tunayarc/water-level-indicator/report/water-level-indicator-presentation.pdf

Middle East Technical University

Northern Cyprus Campus

# EEE 202 Design Project Presentation

Project 6: Water Level Indicator

Conductive-Probe-Based Discrete Analog Water Level Indicator Circuit

Tunay Arıcı | Mehmet Yama¸c G¨ung¨or | Arda Ardı¸c | Yi˘gitalp Dellal
2688141 | 2585719 | 2689933 | 2585644

## Outline

Motivation, Applications, and Design Requirements

Implemented Circuit Architecture and Operation

Component Selection and Design Calculations

LTspice Verification, Practical Results, and Improvement Directions

## Motivation, Applications, and Design

## Requirements

## Project Statement and Design Requirements

Given design problem

Design a discrete analog water level indicator circuit that detects the water level inside a container and displays the reached level using LED indicators.

Water height → electrical detection → visible LED output

Design parameter | Requirement
Supply voltage | 5 V ≤ VS ≤ 12 V
Detected levels | At least 3 water levels
Output indicator | LEDs
Sensing method | Conductive probes
Circuit type | Discrete analog implementation

Main requirement interpretation

The circuit must convert different water heights into different visible

## Motivation, Applications, and Historical Context

Why level detection matters

| Preventing tank overflow
| Avoiding dry-running of pumps
| Monitoring stored liquid level
| Providing alarm indication

Typical application areas

| Domestic water tanks
| Reservoirs and storage tanks
| Wastewater systems
| Automatic filling systems

Visual inspection → mechanical float → electrical probe → industrial transmitter

Connection to this project

Our design is an educational discrete analog version of electrical probe-based level detection.

## Industrial Applications: Companies and Devices

Company | Example device type | Typical application
Endress+Hauser | Conductive, radar, ultrasonic, hydrostatic sensors | Tanks, silos, wastewater
VEGA | VEGAPULS radar, VEGAFLEX guided radar sensors | Process tanks, storage tanks
Emerson Rosemount | Radar and guided-wave radar transmitters | Industrial level measurement

Industrial meaning

Industrial level measurement systems use different sensing principles depending on the liquid, tank geometry, safety requirements, and operating environment.

Position of our project

Our circuit is not an industrial transmitter. It is a low-cost educational prototype that models the same basic task: detecting liquid level and producing an output.

## Implemented Design Choices

Minimum project requirement

| 5 V to 12 V supply
| Minimum 3 detected levels
| LED-based indication
| Conductive-probe sensing

Our implemented design

| 12 V DC supply
| Six sensing levels
| First five LEDs: steady
indication
| Highest level: blinking alarm
Minimum 3 levels | −→ | 6-level indicator with alarm behavior

Design decision

The highest water level was separated from normal level indication and used as a warning stage instead of only another steady LED.

## Modular Design Flow and Design Evolution

Conductive probe → base drive → BJT switch → LED output

input stabilization → supply protection → astable alarm stage

Version | Main feature | Design role
V1 | Five-level BJT indicator | Basic sensing principle
V2 | Sixth level + blinking alarm | Critical-level warning
V3 | Stabilization + protection | Final implemented design
V4 | MOSFET-based sensing | Lower-current improvement
V5 | AC-based sensing | Corrosion-reduction direction

Presentation focus

The main focus is Version 3: a BJT-based discrete analog circuit with stabilization, protection, and a blinking alarm stage.

## Implemented Circuit Architecture

## and Operation

## Implemented Version 3 Architecture

Main implemented design

Version 3 is the implemented laboratory circuit. It uses conductive probes, BJT switching stages, LED indicators, input stabilization, reverse-polarity protection, and an astable alarm stage.

Water level → probe contact → BJT switching → LED indication

Protection

| 1N5819
| Reverse-polarity
protection

Protected VCC

Repeated sensing

Ordinary probes
Pn
| Water resistance
| BC547B stages

Alarm stage

| Alarm probe PA
| Astable
multivibrator

Blinking LED DA

Circuit structure

The ordinary levels use repeated modules indexed by n, while PA

## Implemented Version 3 Schematic


How to read this schematic

The left side contains the protected supply input, the middle contains the repeated ordinary sensing-and-indication stages, and the right side contains the alarm-level astable stage.

## Physical Implementation of the Circuit

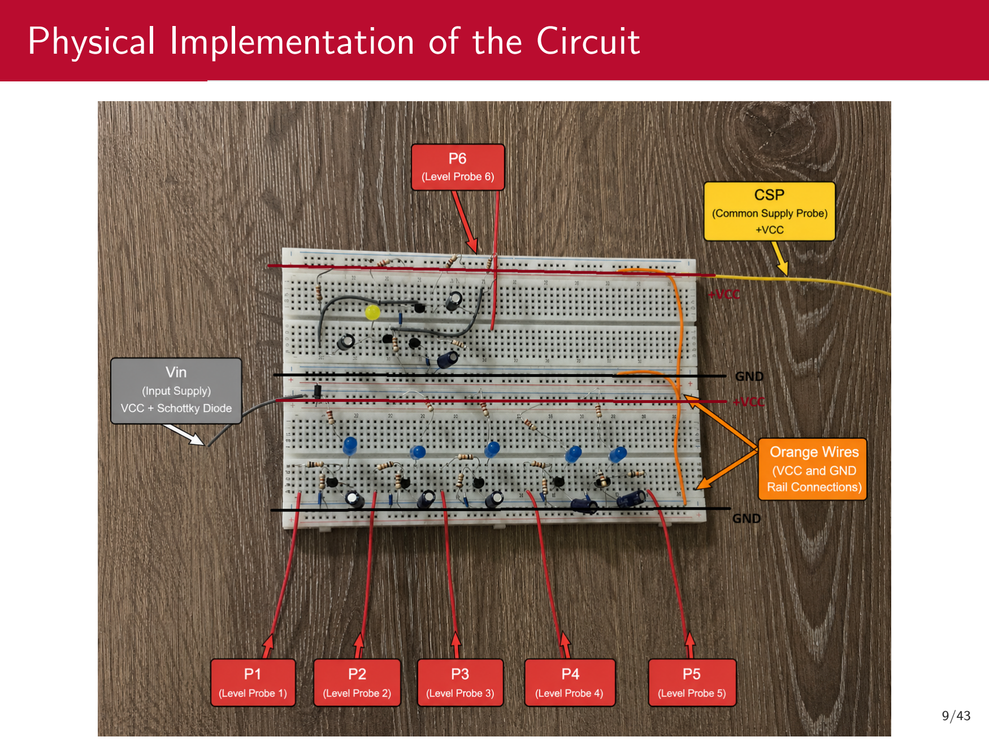
[picture p16: page 12]

## Conductive Probe Sensing and Water Resistance

Sensing principle

When water touches the common supply probe and a level probe Pn, it creates a conductive path that drives the corresponding BJT stage.

VCC → common probe → Rwater,n → Pn → RBASE,n → BJT base

Water reaches Pn → IB,n flows → Qn ON → Dn ON

Rwater,n = ρwater

ℓ
A

=

ℓ

σwaterA

Rwater,n ↑⇒ IB,n ↓⇒ weaker BJT drive

Important physical point

The water path is not an ideal wire. It depends on water conductivity, ion concentration, temperature, probe spacing, and effective contact

## Repeated Sensing and Indication Module

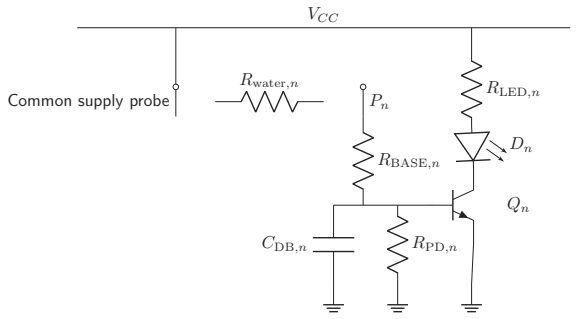
[picture p17: figure]
VCC; Common supply probe; Rwater,n; RBASE,n; CDB,n; RPD,n; RLED,n

Pn reached → Qn ON → Dn ON, n = 1, . . . , 5

Modular meaning

This is the repeated unit of the ordinary level indicators. More levels can be added by repeating the same probe–BJT–LED structure.

## Alarm-Level Module and Astable Behavior

Why PA is different

The ordinary probes Pn, where n = 1, . . . , 5, provide normal level indication. The alarm-level probe PA represents the highest water condition and activates the blinking alarm behavior.

PA reached → QAST SW ON → astable enabled → DA blinks

Ordinary levels

| Pn, n = 1, . . . , 5
| Steady LED indication
| Cumulative level display

Alarm level

| PA
| Highest water condition
| Blinking warning output

Design reason

The highest level is not only information; it is a warning condition. A
blinking LED is more noticeable than another steady LED. | 12/43

## Input Stabilization and Protection

Pull-down resistor

| Prevents floating base nodes
| Keeps dry probe OFF

VB,n ≈ 0 ⇒ Qn OFF

Debounce capacitor

| Smooths fast contact changes
| Reduces flickering

water motion → smoothed input

Protection diode

| 1N5819
| Series supply protection
| Blocks reverse polarity

VCC,eff ≈ 11.7 V

Practical role

These elements make the circuit more suitable for physical implementation, not only for ideal simulation.

## Sequential Operation Summary

Water level condition | Circuit response
Below P1 | All LEDs OFF
Water reaches P1 | D1 ON
Water reaches P2 | D1, D2 ON
Water reaches P3 | D1, D2, D3 ON
Water reaches P4 | D1 to D4 ON
Water reaches P5 | D1 to D5 ON steadily
Water reaches PA | DA blinks as alarm

Main operational feature

The circuit separates ordinary cumulative level indication from alarm-level blinking behavior.

## BJT Limitation and MOSFET Improvement Direction

Implemented BJT sensing

IB,n ≈

VCC − VBE

Rwater,n + RBASE,n

IB,n ≳

IC,n

βforced

ILED,n ≈

VCC − VF,n − VCE,n

RLED,n

If Rwater,n increases, base current decreases and the BJT may be driven more weakly.

MOSFET-based improvement

IG ≈ 0

VGS > Vth

VDS(on) ≈ IDRDS(on)

The water path mainly establishes gate voltage instead of supplying continuous base current.

Design insight

The BJT version was implemented because it is simple and available. A properly protected MOSFET version can reduce sensing current, reduce corrosion risk, and make switching less dependent on water-path current.

## Component Selection and Design

## Calculations

## Design Strategy and Main Assumptions

Main purpose

The component values were selected to make the circuit visible, stable, low-power, and suitable for laboratory implementation.

Supply → LED current → BJT switching → stabilization → alarm timing → power check

Quantity | Assumed value
Input supply voltage | VS = 12 V
Schottky diode drop | VD ≈ 0.3 V
Effective supply | VCC,eff ≈ 11.7 V
BJT base-emitter voltage | VBE ≈ 0.7 V
BJT saturation voltage | VCE(sat) ≈ 0.2 V
Modeled water resistance | Rwater,n = 100 kΩ
Target LED current | ILED ≈ 5 mA

Presentation focus

Only key equations and design values are shown here; detailed

## Component Roles and Datasheet Checks

Selected components

Component | Role
1N5819 | Reverse protection
BC547B | LED switching
LEDs Dn, DA | Visual outputs
LED resistors | Current limiting
Base resistors | Base-current limiting
1 MΩ | Pull-down network
1 µF | Input stabilization
68 kΩ, 10 µF | Astable timing

Suitability checks

Part | Value | Check
BC547B | VCEO = 45 V | > 12 V
BC547B | IC = 100 mA | > 5 mA
1N5819 | VRRM = 40 V | > 12 V
1N5819 | IF ≈ 1 A | > Itotal
Supply | 0–25 V | supports 12 V

Engineering purpose

Component ratings were checked to ensure that the selected parts operate below their main voltage and current limits.

## Supply and LED Current Design

Supply and protection

5 V ≤ VS ≤ 12 V

VS = 12 V

VCC,eff ≈ 12 V − 0.3 V = 11.7 V

| 1N5819 Schottky diode
| Lower drop than silicon diode
| Reverse-polarity protection

LED resistor design

ILED ≈ 5 mA

RLED,n ≈

VCC,eff − VF,n − VCE(sat)

ILED,n

LED | VF | RLED | ILED
Blue | 3.2 V | 1.8 kΩ | 4.61 mA
Orange | 2.0 V | 2.0 kΩ | 4.75 mA
Green | 2.1 V | 2.0 kΩ | 4.70 mA
Yellow | 2.0 V | 2.0 kΩ | 4.75 mA
Red | 1.9 V | 2.0 kΩ | 4.80 mA
Clear/DA | 3.2 V | 1.8 kΩ | 4.61 mA

Brightness note

Similar current does not guarantee identical perceived brightness, because LED color, efficiency, and manufacturer differences also matter.

## BJT Switching and Saturation Check

Modeled switching condition

Rwater,n = 100 kΩ

IB,n ≈ 0.1 mA

IC,n ≈ ILED,n ≈ 5 mA

βrequired =

IC,n

IB,n

≈

5 mA
0.1 mA

= 50

Forced current gain check

βforced =

IC
IB
For conservative switch design,

βforced ≈ 10

IB,forced ≈

5 mA
10

= 0.5 mA

ILED,n ≈

VCC,eff − VF,n − VCE,n

RLED,n

Interpretation

The BJT can switch under the modeled water condition, but the available base current does not guarantee deep saturation for all real water samples.

## Input Stabilization and Alarm Timing

Input stabilization

RPD,n = 1 MΩ

CDB,n = 1 µF

τ = ReqC

τon ≈ 0.11 s

τoff ≈ RPD,nCDB,n = 1.0 s

Alarm timing for DA
For a symmetric BJT astable,

f ≈

1
1.386RC

R = 68 kΩ, C = 10 µF

f ≈ 1.06 Hz

DA → approximately one blink per second

Engineering interpretation

The input network suppresses brief contact disturbances, while the
astable timing produces a clearly visible alarm blink. | 20/43

## Current, Power, and Main Practical Limitation

Estimated current

Itotal ≈ 30 mA − 40 mA

| Several LEDs may be ON together
| Astable stage adds extra current
| Still below supply limits

Estimated power

Ptotal ≈ VCC,effItotal

0.35W ≲ Ptotal ≲ 0.47W

Ptotal < 0.5W ⇒ low thermal stress

Main practical limitation

The circuit is not mainly limited by heating. More important concerns are water conductivity variation, DC sensing current, electrolysis, and probe corrosion.

## From Design Values to LTspice Verification

What was established

The main component values were selected from the supply range, target LED current, BJT switching condition, input stabilization behavior, alarm timing, and power budget.

selected component values → expected circuit behavior → LTspice verification

Next step

After selecting the values, the complete Version 3 circuit must be verified in LTspice: sequential LED operation, alarm triggering, blinking behavior, current, and power.

## LTspice Verification, Practical

## Results, and Improvement Directions

## LTspice Verification Approach

Purpose of simulation

LTspice was used to verify whether the complete Version 3 circuit produces the intended electrical behavior before interpreting the physical experiment.

modeled water contact → BJT switching → LED response → alarm behavior → supply-side behavior

Simulation model

Water contact modeled by controlled switches

| Water path modeled resistively
| Probes activated sequentially

Observed quantities

| Trigger signals and base nodes
| BJT collector behavior
| LED and alarm currents
| Supply voltage, current, and power

Notation

In this presentation, PA corresponds to the physical sixth probe P6, and DA corresponds to the alarm LED D6.

## Simulation 1: Sequential Water-Level Triggering


What the simulation shows

The switch-control signals activate one after another, representing a rising water level that reaches the probes sequentially.

P1 → P2 → P3 → P4 → P5 → PA

Physical meaning

This is the simulated input sequence. It means the following plots can be interpreted as the circuit response to a gradually rising water level.

## Physical Result: Sequential Level Indication

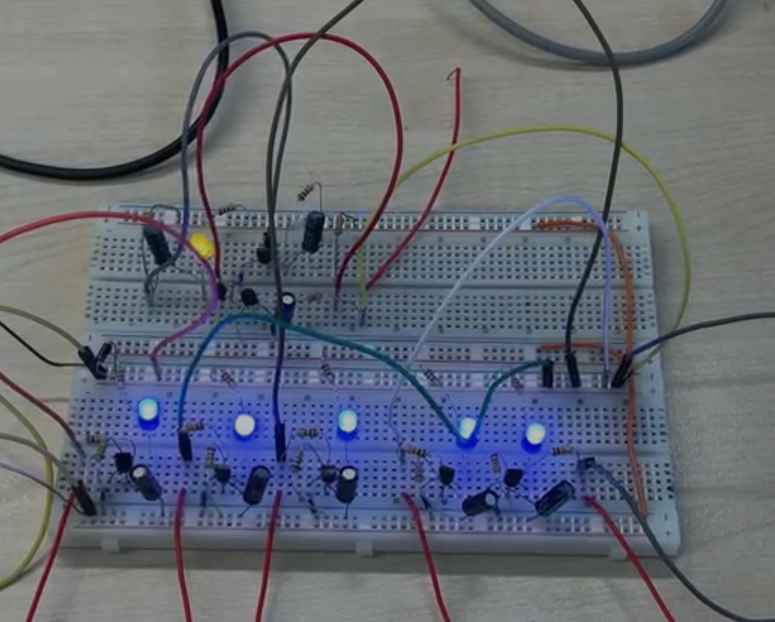
[picture p18: figure]

Experimental observation

## Simulation 2: Input Triggering and RC Delay

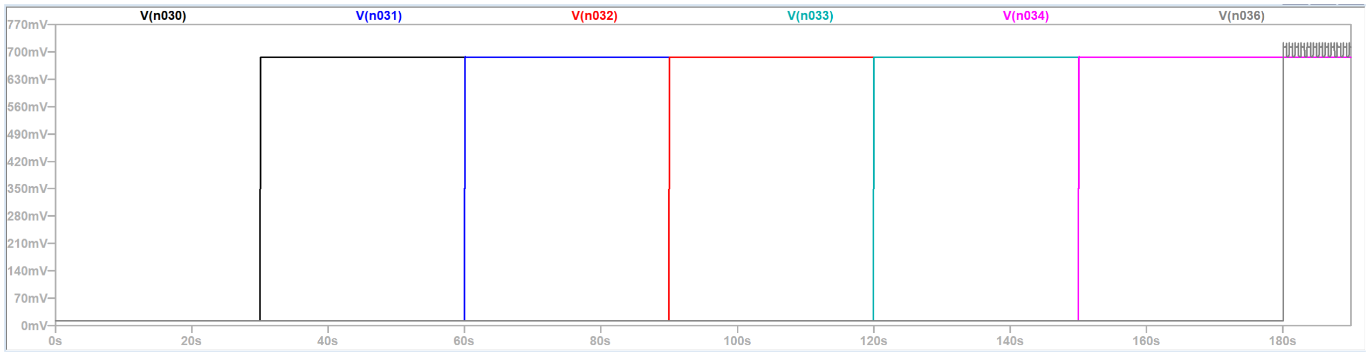
[picture p19: figure]

What the simulation shows

The BJT base-node voltages rise after their corresponding water-contact switches are activated. The first five base nodes settle near the expected silicon junction voltage.

VB,n ≈ 0.68–0.69 V | ⇒ | base-emitter junction forward biased

Physical meaning

Modeled water contact is successfully converted into BJT base drive. The RC network also slows sudden base-node changes, giving input

## Simulation 3: BJT Switching Verification

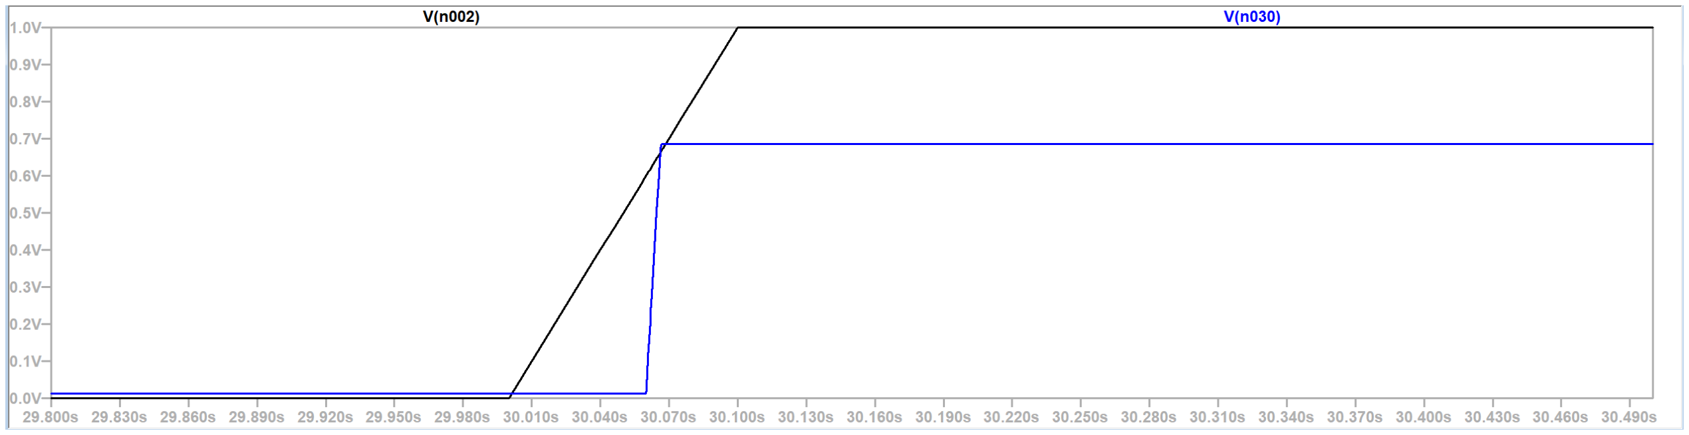
[picture p20: figure]

What the simulation shows

When a sensing stage is activated, the corresponding BJT collector voltage drops close to ground.

Qn ON | ⇒ | VCE,n becomes small | ⇒ | LED current path is completed

Physical meaning

The BJTs behave as low-side switches. They do not generate the LED voltage; they complete the path from LED branch to ground.

## Physical Result: BJT Switching Measurement

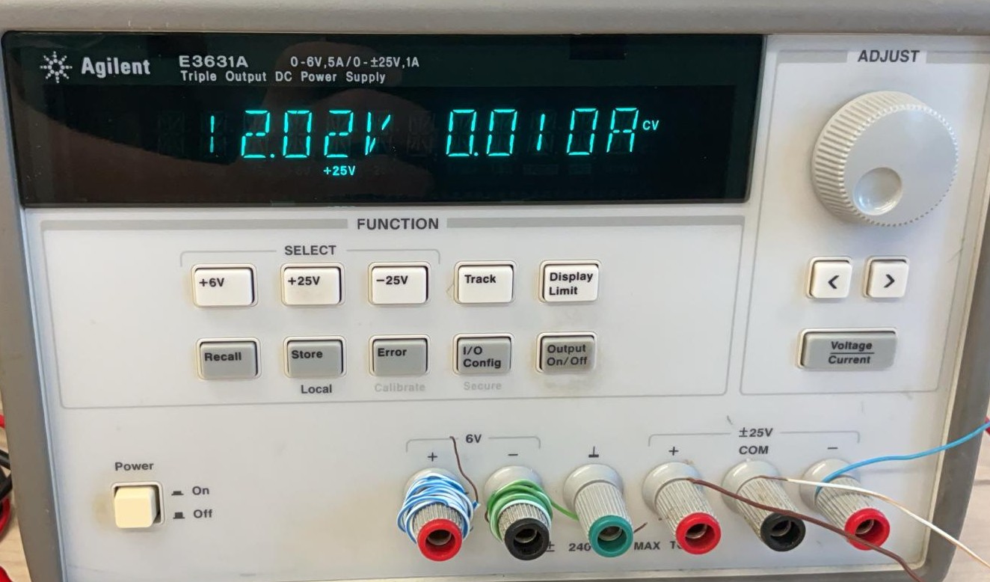
[picture p21: figure]

Measured switching behavior

The ON-state base-emitter voltage was measured around

VBE,ON ≈ 0.729 V,

and the ON-state collector-emitter voltage dropped to a very small

## Simulation 4: LED Currents and Sequential Indication


What the simulation shows

The first five LED currents turn on sequentially and remain close to the intended few-milliampere current range.

ID1

, . . . , ID5 ≈ steady low-current indication

Physical meaning

D1 to D5 behave as ordinary steady water-level indicators rather than blinking or oscillating outputs.

## Physical Result: LED Current and Activation

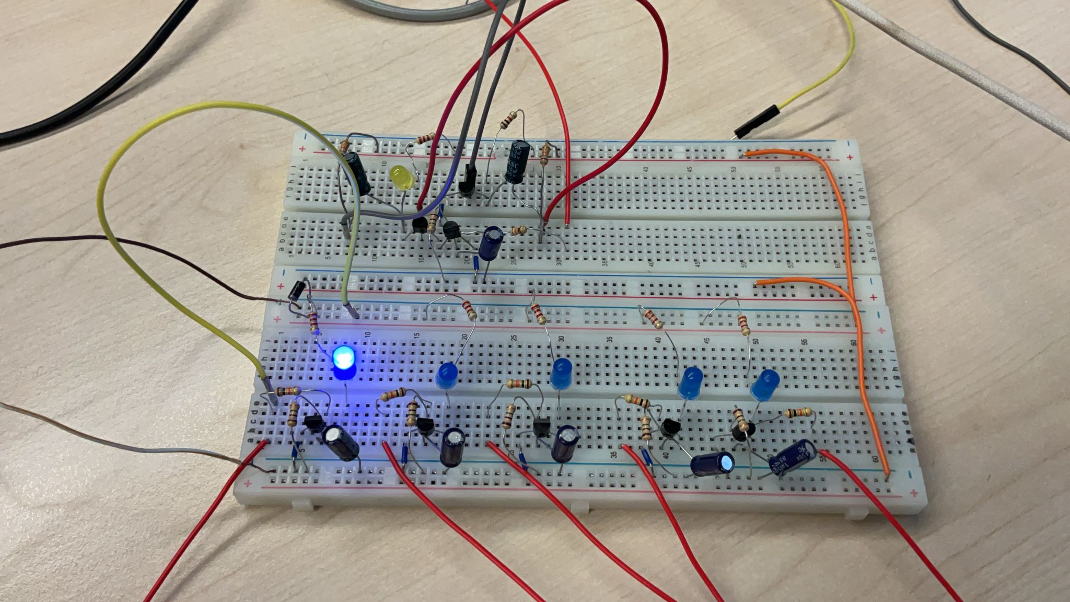
[picture p22: figure]

Measured LED current

For a representative LED branch, the physical current was in the intended few-milliampere range.

ILED,calc ≈ 4.09 mA

ILED,meter ≈ 3.91 mA

Experimental meaning

The LEDs operate near the
designed low-current range, so the indicator is visible without drawing large current.

## Simulation 5: Alarm LED Blinking


What the simulation shows

After the alarm-level input is activated, the alarm LED current switches periodically between nearly zero and its ON-state current.

PA activated → astable enabled → DA alternates ON/OFF

Physical meaning

The highest level is not displayed as another steady LED; it is converted into a blinking warning signal.

## Physical Result: Alarm Blinking

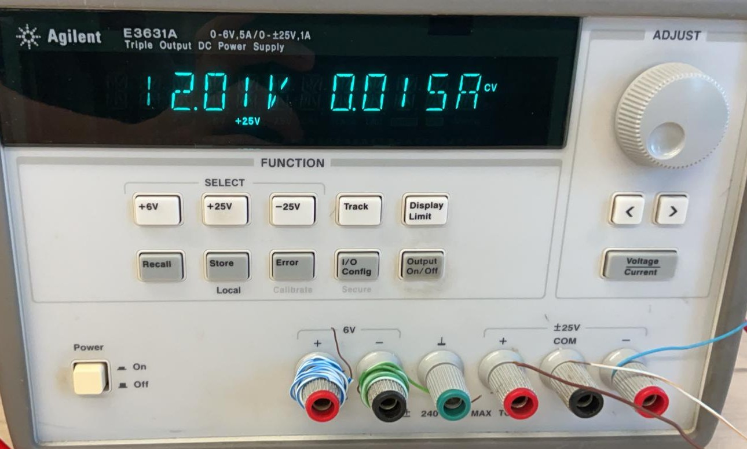
[picture p23: figure]

Video verification

The alarm behavior was also verified by video. The video file can be opened from:
figures/11.17.mp4

## Simulation 6: Astable Multivibrator Operation


What the simulation shows

The two astable node voltages alternate periodically between high and low states.

QAST1 ON ↔ QAST2 ON

Physical meaning

The blinking alarm is not caused by random flickering. It is produced by the internal oscillation of the astable multivibrator.

## Simulation 7: Protected Supply Voltage


What the simulation shows

The protected supply rail remains close to the input supply, with only a small reduction due to the Schottky protection diode and loading.

VCC ≈ Vin − VD

Physical meaning

The protection diode protects the circuit without removing too much usable voltage from the LED branches and BJT stages.

## Physical Result: Protected Rail Measurement

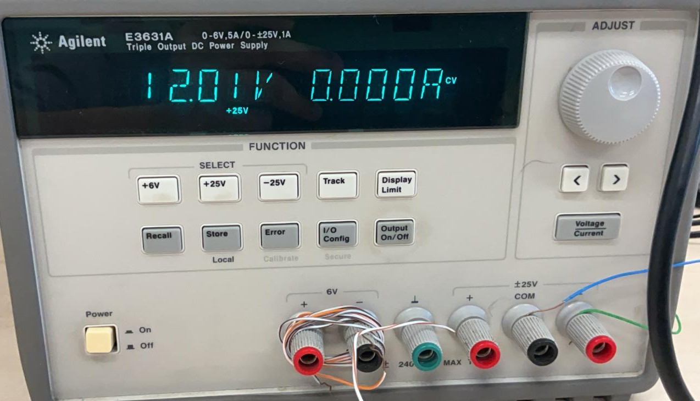
[picture p24: figure]

Measured supply values

The physical measurement gave approximately

Vin = 12.01 V, VCC = 11.7562 V.

## Simulation 8: Supply Current and Power

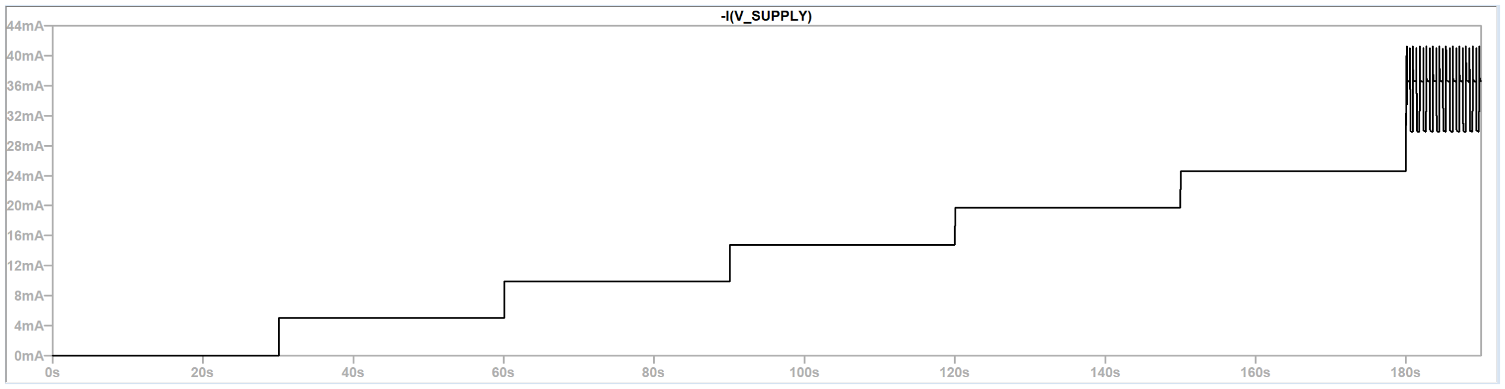
[picture p25: figure]

What the simulation shows

The supply current increases step by step as additional LED branches are activated. After PA, the astable stage adds periodic current variation.

Psimulated < 0.5W

Physical meaning

The circuit operates in a low-current and low-power range. Heating is
not expected to be the dominant limitation. | 36/43

## Physical Result: Supply Current and Power

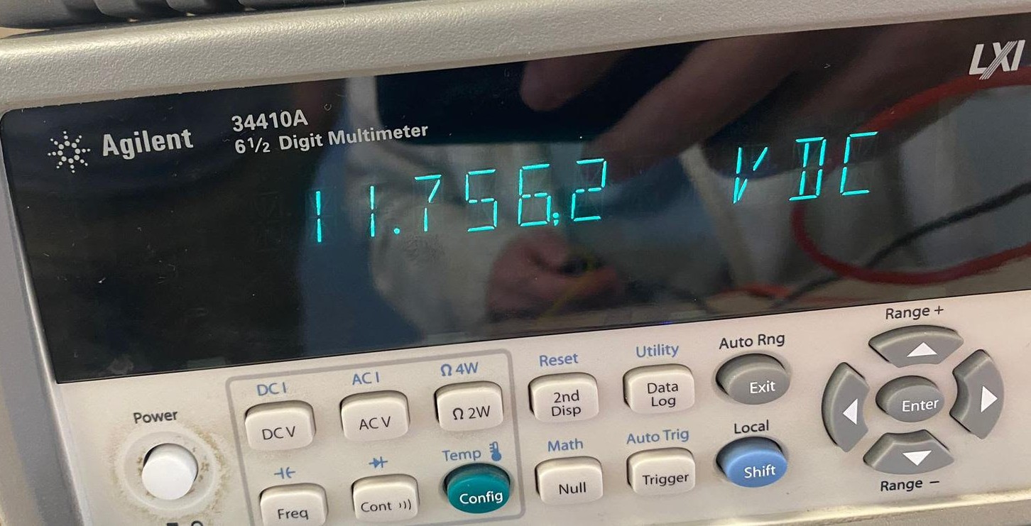
[picture p26: figure]

Measured trend

The measured supply current increased as more stages became active.

IP1 ≈ 0.005 A, IPA ≈ 0.038 A

## Simulation and Physical Experiment Comparison

LTspice simulation

| Controlled switch activation
| Fixed modeled water resistance
| Clean waveforms
| Idealized contact behavior

Physical experiment

| Real water conductivity
| Probe contact variation
| Breadboard contact effects
| Component tolerances

water contact → BJT switching → steady LEDs → PA alarm → DA blinking

Main comparison

Exact numerical agreement is not the main criterion. The important result is that both simulation and physical testing verify the same operating sequence.

## Practical Limitations of the Implemented Design

Main limitation

The main limitation is not thermal power dissipation. The main limitation is the sensing method itself: DC conductive sensing through water and metal probes.

| Water conductivity changes with water type, dissolved ions, and
| impurities.
| Probe-water contact can be unstable due to surface motion or
| partial wetting.
| Breadboard construction can introduce contact resistance and loose
| connections.
| Component tolerances affect LED current, RC delay, and blinking
| frequency.
| DC probe current can cause electrolysis and probe corrosion during
| long-term use.

Design consequence

The implemented Version 3 circuit works as a laboratory demonstration,

## MOSFET-Based Improvement Direction I

Why a MOSFET version is considered

The implemented BJT version requires base current through the water path. If water resistance increases, the available base current decreases and switching becomes weaker.

BJT sensing

IB ≈

VCC − VBE

Rwater + RBASE

Rwater ↑⇒ IB ↓

| Current-controlled
| Needs water-path current
| More dependent on conductivity

MOSFET sensing

IG ≈ 0

VGS > Vth

| Voltage-controlled
| Much smaller steady input current
| Less loading of the water path

Improvement idea

The MOSFET version keeps the same output function but improves the sensing interface.

## MOSFET-Based Improvement Direction II


Expected advantage

A MOSFET-based sensing stage can reduce continuous sensing current through the water path. This helps reduce electrolysis and probe corrosion risk.

VDS(on) ≈ IDRDS(on)

Protection requirement

The MOSFET gate must be protected. A gate-source zener clamp can limit excessive |VGS| and protect the gate oxide.

## AC-Based Sensing as Future Work

Remaining problem

Even the MOSFET version is still based on conductive-probe sensing. If the sensing signal has a DC component, probe corrosion can still remain a long-term concern.

DC probe current → electrolysis → probe corrosion

AC-based idea

A future version could excite the probes using an AC signal instead of continuous DC sensing. This reduces net DC current through the water.

AC excitation → reduced net DC current → better long-term durability

Future direction

The AC-based version is not implemented here, but it is the strongest

## Final Conclusion

Project result

A six-level conductive-probe-based discrete analog water level indicator was designed, simulated, and physically tested.

| The requirement was at least three detected water levels.
| The implemented design uses five steady indicators and one alarm
| level.
| LTspice verifies the internal switching, LED currents, alarm blinking,
| and supply behavior.
| Physical testing confirms the main functional sequence.
| Long-term use would require better probe design and preferably
| AC-based sensing.
Pn → Dn steady indication, | PA → DA blinking alarm

Main conclusion

The implemented Version 3 circuit satisfies the design requirements and
