tunayarc/water-level-indicator/simulation/v2-sixth-level-alarm.asc

C_AST1: cap; 10µ
C_AST2: cap; 10µ
D1: LED; LED_BLU
D2: LED; LED_ORG
D3: LED; LED_GRN
D4: LED; LED_YLW
D5: LED; LED_RED
D6: LED; LED_CLR
D_PROT: schottky; 1N5819
Q1: npn; BC547B
Q2: npn; BC547B
Q3: npn; BC547B
Q4: npn; BC547B
Q5: npn; BC547B
Q_AST1: npn; BC547B
Q_AST2: npn; BC547B
Q_AST_SW: npn; BC547B
R_B6: res; 68k
R_B7: res; 68k
R_BASE1: res; 10k
R_BASE2: res; 10k
R_BASE3: res; 10k
R_BASE4: res; 10k
R_BASE5: res; 10k
R_BASE6: res; 10k
R_C7: res; 1k
R_LED1: res; 1.8k
R_LED2: res; 2k
R_LED3: res; 2k
R_LED4: res; 2k
R_LED5: res; 2k
R_LED6: res; 1.8k
S1: sw; WATER_SW
S2: sw; WATER_SW
S3: sw; WATER_SW
S4: sw; WATER_SW
S5: sw; WATER_SW
S6: sw; WATER_SW
V_SUPPLY: voltage; 12
WATER_V1: voltage; PULSE(0 1 30 0.1 0.1 1000 2000)
WATER_V2: voltage; PULSE(0 1 60 0.1 0.1 1000 2000)
WATER_V3: voltage; PULSE(0 1 90 0.1 0.1 1000 2000)
WATER_V4: voltage; PULSE(0 1 120 0.1 0.1 1000 2000)
WATER_V5: voltage; PULSE(0 1 150 0.1 0.1 1000 2000)
WATER_V6: voltage; PULSE(0 1 180 0.1 0.1 1000 2000)
Named nets: 0, BUZZ
.model WATER_SW SW(Ron=100k Roff=1G Vt=0.5 Vh=0.1)
.tran 0 190 0 0.1
.model LED_BLU D(IS=1.2e-22 N=2.5 RS=5.5 BV=5 IBV=10u)
.model LED_ORG D(IS=5.4e-20 N=2.02 RS=4.2 BV=5 IBV=10u)
.model LED_GRN D(IS=2.3e-20 N=2.05 RS=4.8 BV=5 IBV=10u)
.model LED_YLW D(IS=5.4e-20 N=2.02 RS=4.2 BV=5 IBV=10u)
.model LED_RED D(IS=9.6e-20 N=2.0 RS=3.6 BV=5 IBV=10u)
.model LED_CLR D(IS=1.2e-22 N=2.5 RS=5.5 BV=5 IBV=10u)
