tunayarc/water-level-indicator/simulation/v4-mosfet-proposed.asc

C_AST1: cap; 10µ
C_AST2: cap; 10µ
C_DB1: cap; 1µ; V=50 Irms=6.2m Rser=2.6679 Lser=852p mfg="Würth Elektronik" pn="865230640005 WCAP-AS5H 4x5,5" type="Al electrolytic"
C_DB2: cap; 1µ; V=50 Irms=6.2m Rser=2.6679 Lser=852p mfg="Würth Elektronik" pn="865230640005 WCAP-AS5H 4x5,5" type="Al electrolytic"
C_DB3: cap; 1µ; V=50 Irms=6.2m Rser=2.6679 Lser=852p mfg="Würth Elektronik" pn="865230640005 WCAP-AS5H 4x5,5" type="Al electrolytic"
C_DB4: cap; 1µ; V=50 Irms=6.2m Rser=2.6679 Lser=852p mfg="Würth Elektronik" pn="865230640005 WCAP-AS5H 4x5,5" type="Al electrolytic"
C_DB5: cap; 1µ; V=50 Irms=6.2m Rser=2.6679 Lser=852p mfg="Würth Elektronik" pn="865230640005 WCAP-AS5H 4x5,5" type="Al electrolytic"
C_DB6: cap; 1µ; V=50 Irms=6.2m Rser=2.6679 Lser=852p mfg="Würth Elektronik" pn="865230640005 WCAP-AS5H 4x5,5" type="Al electrolytic"
D1: LED; LED_BLU
D2: LED; LED_ORG
D3: LED; LED_GRN
D4: LED; LED_YLW
D5: LED; LED_RED
D6: LED; LED_CLR
D_PROT: schottky; 1N5819
M1: nmos; BS170
M2: nmos; BS170
M3: nmos; BS170
M4: nmos; BS170
M5: nmos; BS170
M_AST_SW: nmos; BS170
Q_AST1: npn; BC547B
Q_AST2: npn; BC547B
R_B6: res; 68k
R_B7: res; 68k
R_C7: res; 1k
R_GATE1: res; 10k
R_GATE2: res; 10k
R_GATE3: res; 10k
R_GATE4: res; 10k
R_GATE5: res; 10k
R_GATE6: res; 10k
R_LED1: res; 1.8k
R_LED2: res; 2k
R_LED3: res; 2k
R_LED4: res; 2k
R_LED5: res; 2k
R_LED6: res; 1.8k
R_PD1: res; 1Meg
R_PD2: res; 1Meg
R_PD3: res; 1Meg
R_PD4: res; 1Meg
R_PD5: res; 1Meg
R_PD6: res; 1Meg
S1: sw; WATER_SW
S2: sw; WATER_SW
S3: sw; WATER_SW
S4: sw; WATER_SW
S5: sw; WATER_SW
S6: sw; WATER_SW
V_SUPPLY: voltage; 12
WATER_V1: voltage; PULSE(0 1 30 0.1 0.1 1000 2000)
WATER_V2: voltage; PULSE(0 1 60 0.1 0.1 1000 2000)
WATER_V3: voltage; PULSE(0 1 90 0.1 0.1 1000 2000)
WATER_V4: voltage; PULSE(0 1 120 0.1 0.1 1000 2000)
WATER_V5: voltage; PULSE(0 1 150 0.1 0.1 1000 2000)
WATER_V6: voltage; PULSE(0 1 180 0.1 0.1 1000 2000)
Z_ZG1: zener; DI_1N4742A
Z_ZG2: zener; DI_1N4742A
Z_ZG3: zener; DI_1N4742A
Z_ZG4: zener; DI_1N4742A
Z_ZG5: zener; DI_1N4742A
Z_ZG6: zener; DI_1N4742A
Named nets: 0
.param RW=100k
.step param RW list 10k 50k 100k 500k 1Meg 2Meg 5Meg
.model WATER_SW SW(Ron={RW} Roff=1G Vt=0.5 Vh=0.1)
.tran 0 190 0 0.1
.model LED_BLU D(IS=1.2e-22 N=2.5 RS=5.5 BV=5 IBV=10u)
.model LED_ORG D(IS=5.4e-20 N=2.02 RS=4.2 BV=5 IBV=10u)
.model LED_GRN D(IS=2.3e-20 N=2.05 RS=4.8 BV=5 IBV=10u)
.model LED_YLW D(IS=5.4e-20 N=2.02 RS=4.2 BV=5 IBV=10u)
.model LED_RED D(IS=9.6e-20 N=2.0 RS=3.6 BV=5 IBV=10u)
.model LED_CLR D(IS=1.2e-22 N=2.5 RS=5.5 BV=5 IBV=10u)
.model BS170 VDMOS VTO=1.824 RG=270 RS=1.572 RD=1.436 RB=.768 KP=.1233 Cgdmax=20p Cgdmin=3p CGS=28p Cjo=35p Rds=1.2E8 IS=5p Bv=60 Ibv=10u Tt=161.6n
.OPTIONS ALLOW_AMBIGUOUS_MODELS
.include zener.lib
